EmanuelSanchez/Line-Follower/Images/matriz2.jpg

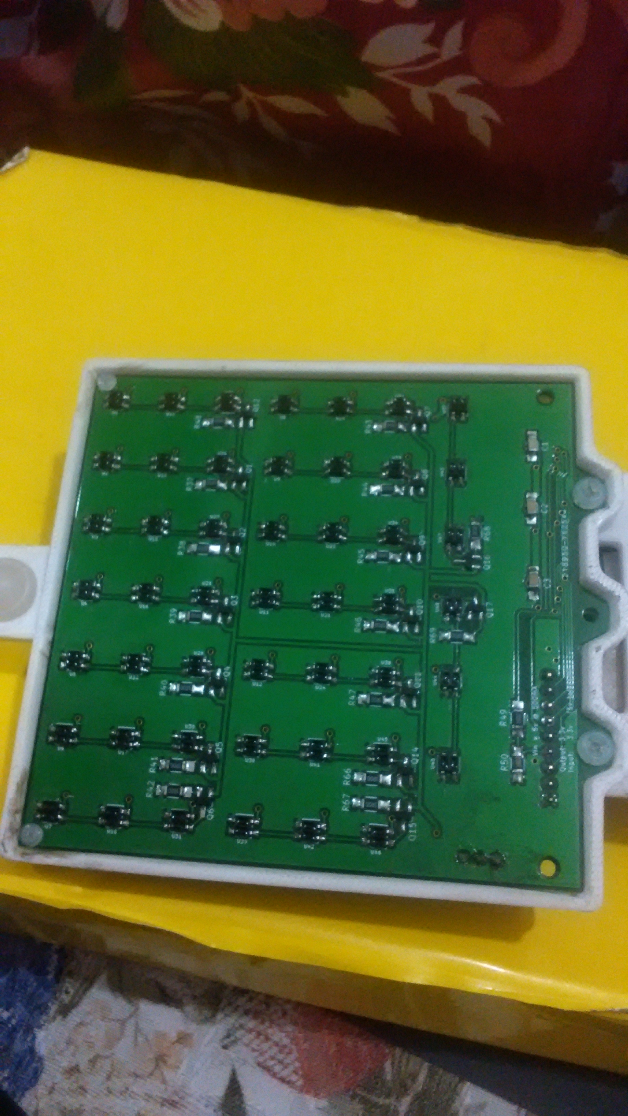
Images/matriz2.jpg
