EmanuelSanchez/Line-Follower/Schematics/Control 1.png

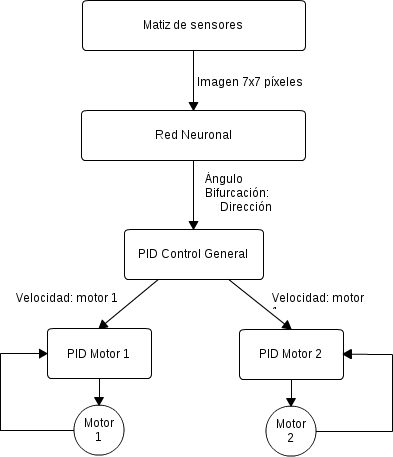
Schematics/Control 1.png
