EmanuelSanchez/Line-Follower/Schematics/Control 2.png

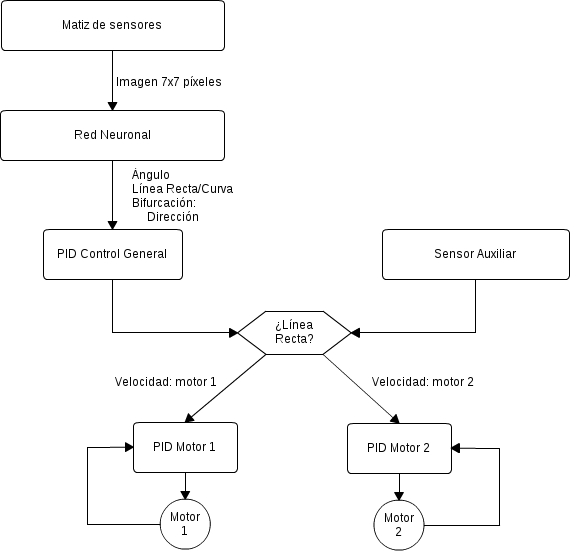
Schematics/Control 2.png
