EmanuelSanchez/Line-Follower/Schematics/Velocista.png

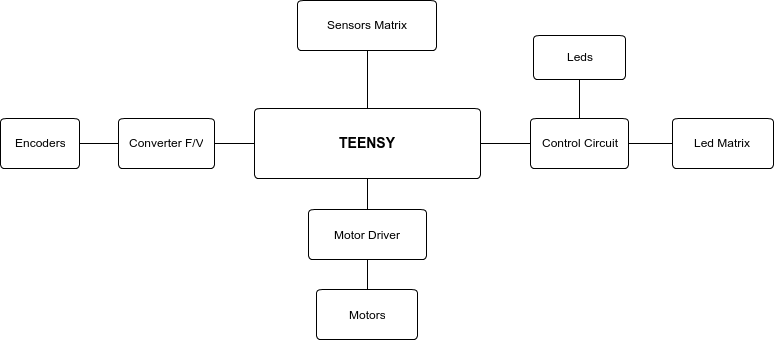
Schematics/Velocista.png
