EmanuelSanchez/Line-Follower/Bill of Materials.ods

Nombre | Empresa | Precio | Cantidad | Sub Total | Link
Motores DC | Pololu | 17.95 | 2 | 35.9 | https://www.pololu.com/product/3061
Encoders Magnéticos | Pololu | 8.95 | 2 | 17.9 | https://www.pololu.com/product/3081
LCD |  |  | 1 | 0
Teensey |  | 24.94 | 1 | 24.94 | http://ve.mouser.com/ProductDetail/Adafruit/2756/?qs=sGAEpiMZZMuSK2mCDyT9crBR9UUNDPltQqpZaqADC8g%3d
Rueda Loca |  |  |  | 0
 |  |  |  | 0
 |  |  |  | 0
 |  |  |  | 0
 |  |  |  | 0
 |  |  |  | 0
Total |  |  |  | 78.74
