EmanuelSanchez/Line-Follower/software/src/pinout.h

/*


*/

#ifndef __PINOUTS_H__
#define __PINOUTS_H__

// Pins Definitions
//Motors:
#define motorL_en 3      // violet wire
#define motorL_phase 2   // blue wire
#define motorR_en 4      // violet wire
#define motorR_phase 5   // blue wire

// Sensor Matrix Definitions
// using two incompatible SPI devices, A and B
#define ADC_chip_1 10
#define ADC_chip_2 21
#define ADC_chip_3 20
#define EOC   1

#endif
