EmanuelSanchez/Line-Follower/(commit log)

2016-10-07 Motors Tests
2016-10-13 Some legal Files
    [Bill of Materials.ods, Proyecto Velocista.ods]
2016-10-13 removed motors1
